imroshankr/Metal_detector/Metal_detector/report.txt

Info: Processing symbol 'C1:Capacitor_THT:C_Radial_D5.0mm_H11.0mm_P2.00mm'.
Info: Processing symbol 'R22:Resistor_THT:R_Axial_DIN0204_L3.6mm_D1.6mm_P7.62mm_Horizontal'.
Info: Processing symbol 'R23:Resistor_THT:R_Axial_DIN0204_L3.6mm_D1.6mm_P7.62mm_Horizontal'.
Info: Processing symbol 'R24:Resistor_THT:R_Axial_DIN0204_L3.6mm_D1.6mm_P7.62mm_Horizontal'.
Info: Processing symbol 'R25:Resistor_THT:R_Axial_DIN0204_L3.6mm_D1.6mm_P7.62mm_Horizontal'.
Info: Processing symbol 'C2:Capacitor_THT:C_Disc_D5.0mm_W2.5mm_P2.50mm'.
Info: Processing symbol 'C3:Capacitor_THT:C_Disc_D5.0mm_W2.5mm_P2.50mm'.
Info: Processing symbol 'C4:Capacitor_THT:C_Radial_D5.0mm_H11.0mm_P2.00mm'.
Info: Processing symbol 'C5:Capacitor_THT:C_Radial_D5.0mm_H11.0mm_P2.00mm'.
Info: Processing symbol 'C6:Capacitor_THT:C_Disc_D3.8mm_W2.6mm_P2.50mm'.
Info: Processing symbol 'C7:Capacitor_THT:C_Disc_D3.8mm_W2.6mm_P2.50mm'.
Info: Processing symbol 'C8:Capacitor_THT:C_Radial_D5.0mm_H11.0mm_P2.00mm'.
Info: Processing symbol 'R26:Resistor_THT:R_Axial_DIN0204_L3.6mm_D1.6mm_P7.62mm_Horizontal'.
Info: Processing symbol 'R27:Resistor_THT:R_Axial_DIN0204_L3.6mm_D1.6mm_P7.62mm_Horizontal'.
Info: Processing symbol 'C9:Capacitor_THT:C_Disc_D5.0mm_W2.5mm_P2.50mm'.
Info: Processing symbol 'R28:Resistor_THT:R_Axial_DIN0204_L3.6mm_D1.6mm_P7.62mm_Horizontal'.
Info: Processing symbol 'C10:Capacitor_THT:C_Disc_D5.0mm_W2.5mm_P2.50mm'.
Info: Processing symbol 'R29:Resistor_THT:R_Axial_DIN0204_L3.6mm_D1.6mm_P7.62mm_Horizontal'.
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
Error: Cannot add J4 (no footprint assigned).
Error: Cannot add J3 (no footprint assigned).
Error: Cannot add J7 (no footprint assigned).
Error: Cannot add U60 (footprint 'SN7404N:DIP794W45P254L1969H508Q14' not found).

Info: Total warnings: 18, errors: 5.
