imroshankr/Metal_detector/Metal_detector/Metal_detector.kicad_pcb

## KiCad design Metal_detector/Metal_detector.kicad_pcb (2024-08-18)

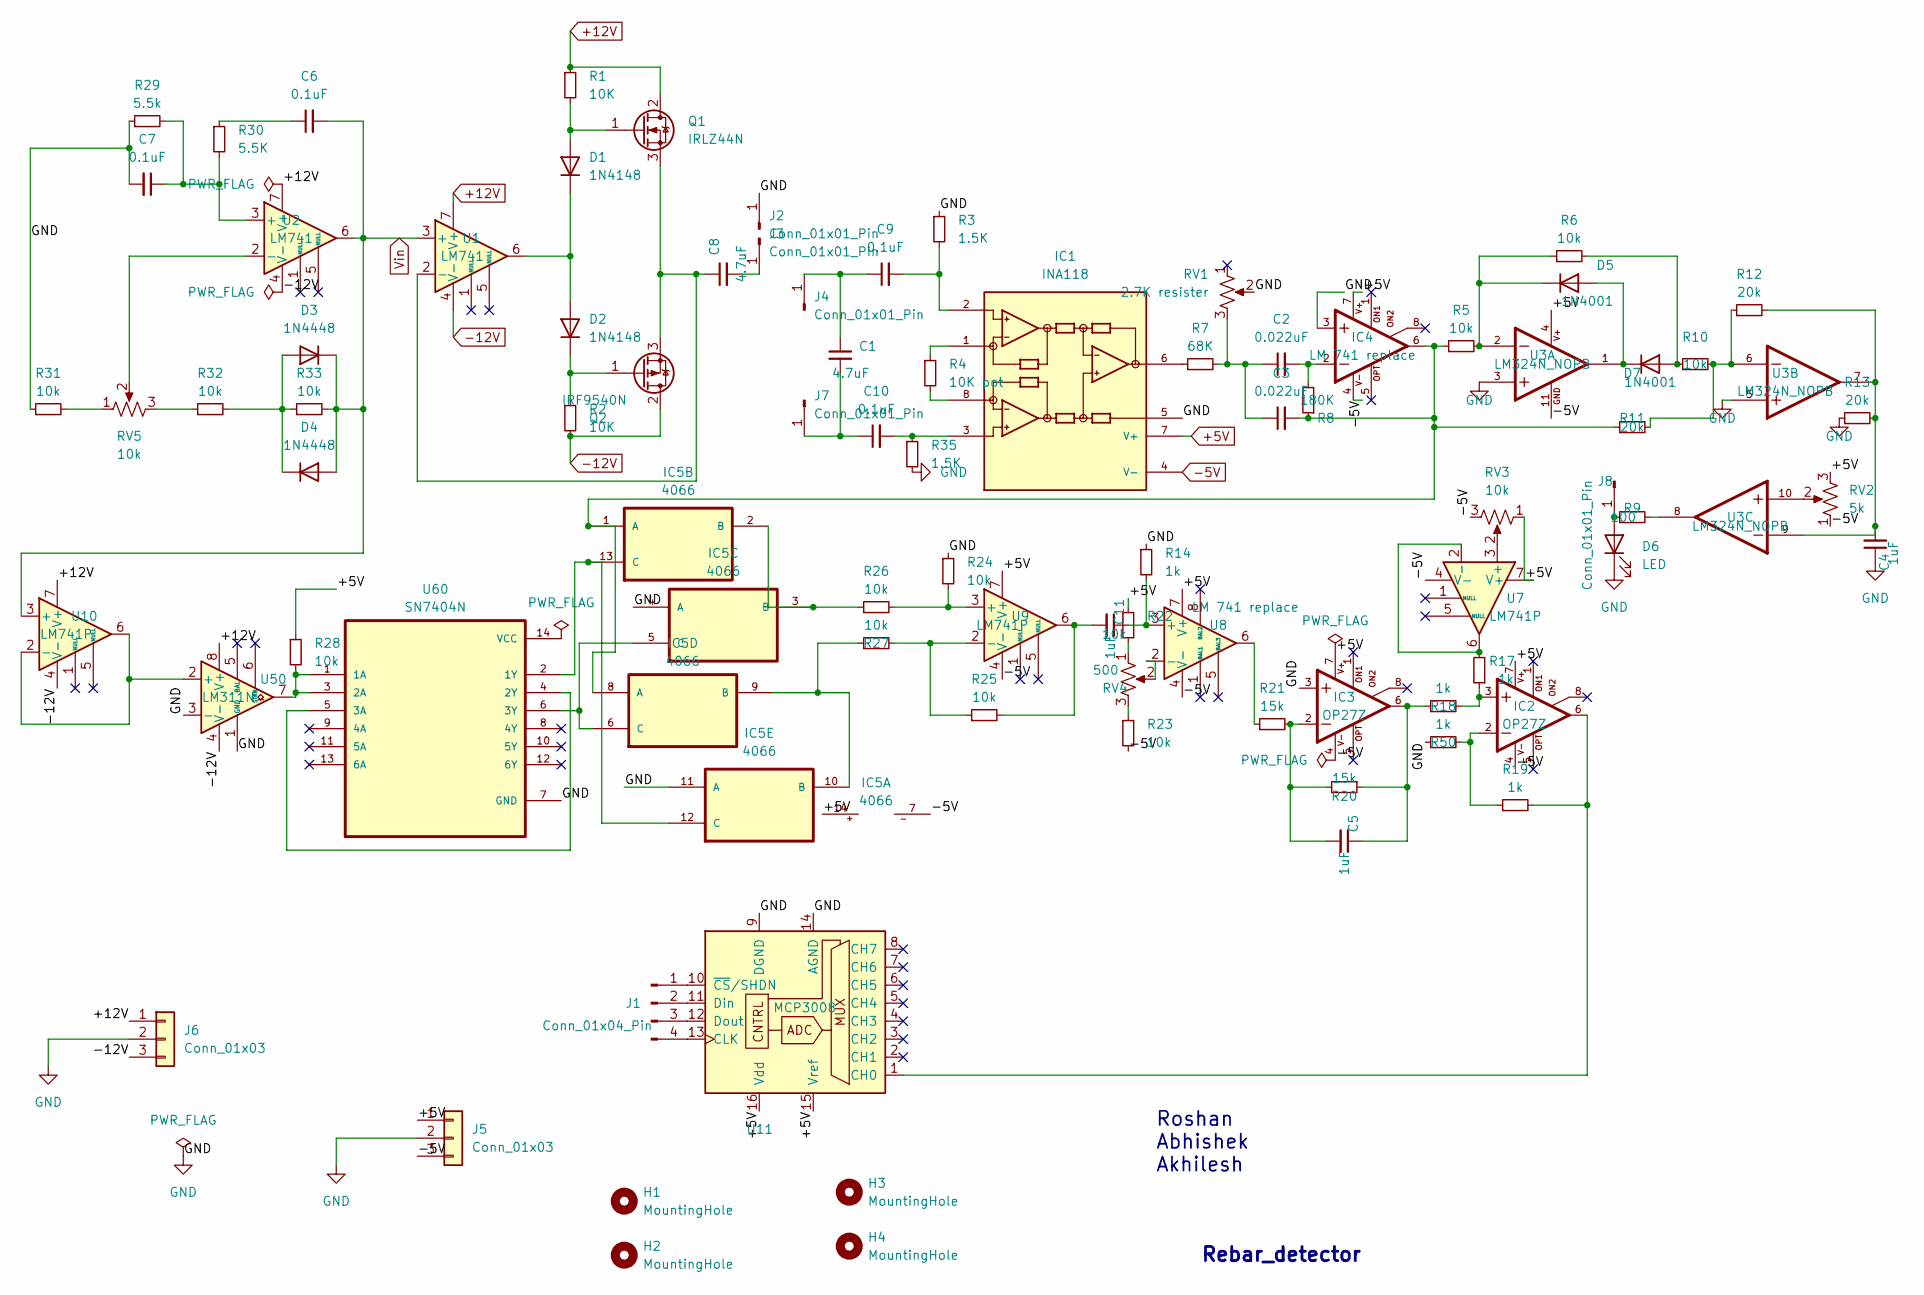
[picture p3: schematic Metal_detector.kicad_sch]

Parts:
C1, C8: 4.7uF; C_Radial_D6.3mm_H5.0mm_P2.50mm
C2, C3: 0.022uF; C_Disc_D5.0mm_W2.5mm_P2.50mm
C4: 1uF; C_Disc_D5.0mm_W2.5mm_P2.50mm
C5, C11: 1uF; C_Radial_D6.3mm_H5.0mm_P2.50mm
C6, C7: 0.1uF; C_Disc_D3.8mm_W2.6mm_P2.50mm
C9, C10: 0.1uF; C_Disc_D5.0mm_W2.5mm_P2.50mm
D1, D2: 1N4148; D_DO-35_SOD27_P7.62mm_Horizontal
D3, D4: 1N4448; D_DO-35_SOD27_P7.62mm_Horizontal
D5, D7: 1N4001; D_DO-41_SOD81_P10.16mm_Horizontal
D6: LED; LED_D3.0mm
H1, H2, H3, H4: MountingHole; MountingHole_3mm
IC1: INA118; DIP-8_W7.62mm_LongPads; MPN INA118U
IC2, IC3: OP27Z; DIP-8_W7.62mm_LongPads
IC4: LM 741 replace; DIP-8_W7.62mm_LongPads
IC5: 4066; DIP-14_W7.62mm_Socket_LongPads
J1: Conn_01x04_Pin; PinHeader_1x04_P2.54mm_Vertical
J2, J3, J4, J7, J8: Conn_01x01_Pin; Pin_D1.1mm_L10.2mm_W3.5mm_Flat
J5, J6: Conn_01x03; PinHeader_1x03_P2.54mm_Vertical
Q1: IRLZ44N; TO-220-3_Vertical
Q2: IRF9540N; TO-220-3_Vertical
R1, R2: 10K; R_Axial_DIN0204_L3.6mm_D1.6mm_P7.62mm_Horizontal
R3, R35: 1.5K; R_Axial_DIN0204_L3.6mm_D1.6mm_P7.62mm_Horizontal
R4: 10K pot; R_Axial_DIN0204_L3.6mm_D1.6mm_P7.62mm_Horizontal
R5, R6, R10, R22, R23, R24, R25, R26, R27, R28, R31, R32, R33: 10k; R_Axial_DIN0204_L3.6mm_D1.6mm_P7.62mm_Horizontal
R7: 68K; R_Axial_DIN0204_L3.6mm_D1.6mm_P7.62mm_Horizontal
R8: 180K; R_Axial_DIN0204_L3.6mm_D1.6mm_P7.62mm_Horizontal
R9: 100; R_Axial_DIN0204_L3.6mm_D1.6mm_P7.62mm_Horizontal
R11, R12, R13: 20k; R_Axial_DIN0204_L3.6mm_D1.6mm_P7.62mm_Horizontal
R14, R17, R18, R19, R50: 1k; R_Axial_DIN0204_L3.6mm_D1.6mm_P7.62mm_Horizontal
R20, R21: 15k; R_Axial_DIN0204_L3.6mm_D1.6mm_P7.62mm_Horizontal
R29: 5.5k; R_Axial_DIN0204_L3.6mm_D1.6mm_P7.62mm_Horizontal
R30: 5.5K; R_Axial_DIN0204_L3.6mm_D1.6mm_P7.62mm_Horizontal
RV1: 2.7K resister; Potentiometer_ACP_CA14-H5_Horizontal
RV2: 5k; Potentiometer_Bourns_3386F_Vertical
RV3, RV5: 10k; Potentiometer_ACP_CA14-H5_Horizontal
RV4: 500; Potentiometer_ACP_CA14-H5_Horizontal
U1, U2: LM741; DIP-8_W7.62mm
U3: LM324N_NOPB; DIP825W47P254L1917H533Q14; PARTREV D
U7, U9, U10: LM741P; DIP-8_W7.62mm
U8: LM 741 replace; DIP-8_W7.62mm
U11: MCP3008; DIP-16_W7.62mm
U50: LM311N; DIP-8_W7.62mm
U60: SN7404N; DIP794W45P254L1969H508Q14

Connections:
+5V: IC1.7 (V+), IC2.7, IC3.7, IC4.7, IC5.14, J5.1, R22.1, R28.1, RV2.3, RV3.1, U3.4, U7.7 (V+), U8.7 (V+), U9.7 (V+), U11.15 (Vref), U11.16 (Vdd)
+12V: J6.1, Q1.2 (D), R1.1, U1.7 (V+), U2.7 (V+), U10.7 (V+), U50.8 (V+)
-5V: IC1.4 (V-), IC2.4, IC3.4, IC4.4, IC5.7, J5.3, R23.2, RV2.1, RV3.3, U3.11, U7.4 (V-), U8.4 (V-), U9.4 (V-)
-12V: J6.3, Q2.2 (D), R2.2, U1.4 (V-), U2.4 (V-), U10.4 (V-), U50.4 (V-)
GND: C4.1, C7.2, D6.1 (K), IC1.5, IC3.3, IC4.3, IC5.4 (A), IC5.11 (A), J2.1, J5.2, J6.2, R3.1, R13.1, R14.1, R24.1, R29.1, R31.1, R35.2, R50.1, RV1.2, U3.3, U3.5, U11.9 (DGND), U11.14 (AGND), U50.1 (GND), U50.3 (-), U60.7 (GND)
unnamed: C2.1, C3.1, R7.2, RV1.3
unnamed: C2.2, IC4.2, R8.2
unnamed: C4.2, R12.2, R13.2, U3.7, U3.9
unnamed: C5.1, IC3.6, R18.1, R20.1
unnamed: C5.2, IC3.2, R20.2, R21.2
unnamed: C6.1, R30.1
unnamed: C9.2, IC1.2, R3.2
unnamed: C10.2, IC1.3, R35.1
unnamed: C11.2, R25.2, U9.6
unnamed: D1.2 (A), Q1.1 (G), R1.2
unnamed: D1.1 (K), D2.2 (A), U1.6
unnamed: D2.1 (K), Q2.1 (G), R2.1
unnamed: D3.2 (A), D4.1 (K), R32.2, R33.1
unnamed: D5.2 (A), D7.1 (K), U3.1
unnamed: D5.1 (K), R5.2, R6.1, U3.2
unnamed: D6.2 (A), J8.1, R9.1
unnamed: D7.2 (A), R6.2, R10.1
unnamed: IC1.1, R4.1
unnamed: IC1.6, R7.1
unnamed: IC1.8, R4.2
unnamed: IC2.2, R19.1, R50.2
unnamed: IC2.3, R17.1, R18.2
unnamed: C3.2, IC4.6, IC5.1 (A), IC5.8 (A), R5.1, R8.1, R11.1
unnamed: IC5.2 (B), IC5.3 (B), R26.1
unnamed: IC5.12 (C), IC5.13 (C), U60.2 (1Y)
unnamed: IC5.5 (C), IC5.6 (C), U60.6 (3Y)
unnamed: IC5.9 (B), IC5.10 (B), R27.1
unnamed: J1.1, U11.10 (~CS/SHDN)
unnamed: J1.2, U11.11 (Din)
unnamed: J1.3, U11.12 (Dout)
unnamed: J1.4, U11.13 (CLK)
unnamed: C8.2, J3.1
unnamed: C1.1, C9.1, J4.1
unnamed: C1.2, C10.1, J7.1
unnamed: C8.1, Q1.3 (S), Q2.3 (S), U1.2 (-)
unnamed: R9.2, U3.8
unnamed: R10.2, R11.2, R12.1, U3.6
unnamed: R21.1, U8.6
unnamed: R22.2, RV4.1
unnamed: R23.1, RV4.3
unnamed: R31.2, RV5.1
unnamed: R32.1, RV5.3
unnamed: RV2.2, U3.10
unnamed: C7.1, R29.2, R30.2, U2.3 (+)
unnamed: RV5.2, U2.2 (-)
unnamed: RV3.2, U7.3 (+)
unnamed: R17.2, U7.2 (-), U7.6
unnamed: C11.1, R14.2, U8.3 (+)
unnamed: RV4.2, U8.2 (-)
unnamed: R24.2, R26.2, U9.3 (+)
unnamed: R25.1, R27.2, U9.2 (-)
unnamed: U10.2 (-), U10.6, U50.2 (+)
unnamed: IC2.6, R19.2, U11.1 (CH0)
unnamed: R28.2, U50.7, U60.1 (1A), U60.3 (2A)
unnamed: U60.4 (2Y), U60.5 (3A)
Vin: C6.2, D3.1 (K), D4.2 (A), R33.2, U1.3 (+), U2.6, U10.3 (+)

Notes on the sheet:
Rebar_detector
Roshan Abhishek Akhilesh

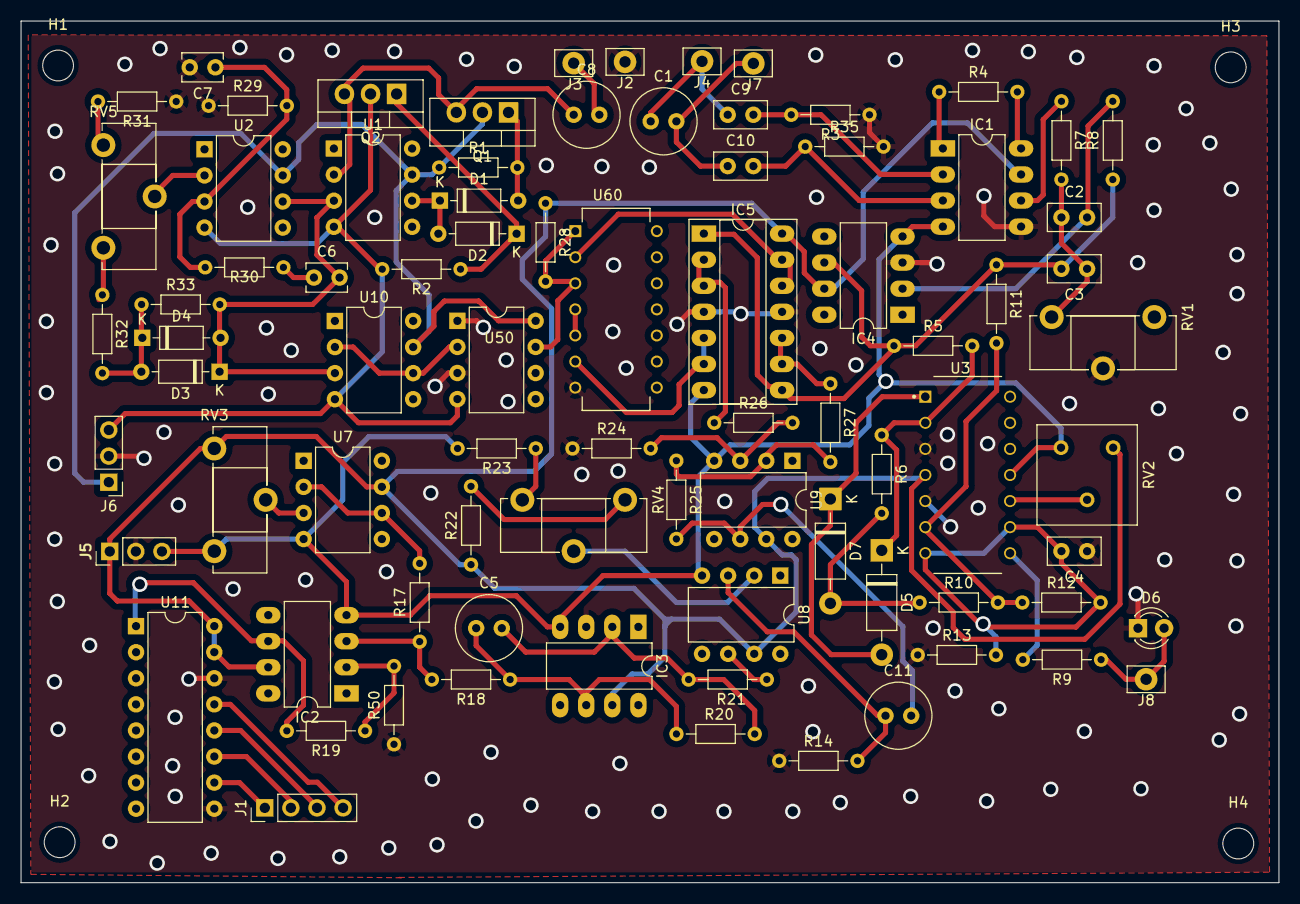
[picture p4: board Metal_detector.kicad_pcb from above]

Board: 2 copper layers, 122.5 x 83.9 mm, 85 parts (0 on the bottom side), 61 nets.
