imroshankr/Metal_detector/Metal_detector/rebar_detector/rebar_detector.kicad_pcb

## KiCad design Metal_detector/rebar_detector/rebar_detector.kicad_pcb (2024-08-18)

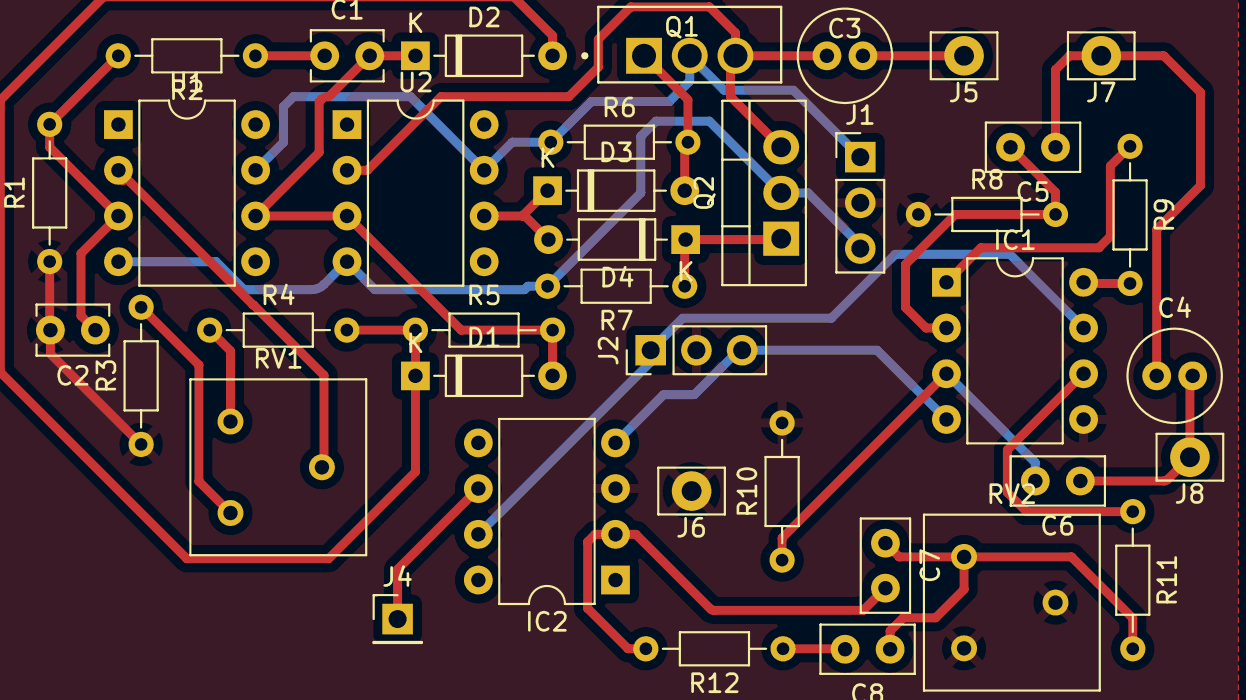
[picture p5: board rebar_detector.kicad_pcb from above]

Board: 2 copper layers, 39 parts (0 on the bottom side), 28 nets.

Parts:
C1, C2: 22pF; C_Disc_D3.8mm_W2.6mm_P2.50mm
C3, C4: 4.7uF; C_Radial_D5.0mm_H11.0mm_P2.00mm
C5, C6, C7, C8: 0.1uF; C_Disc_D5.0mm_W2.5mm_P2.50mm
D1, D2: 1N4448; D_DO-35_SOD27_P7.62mm_Horizontal
D3, D4: 1N4148; D_DO-35_SOD27_P7.62mm_Horizontal
IC1: INA118; DIP-8_W7.62mm
IC2: OP27Z; DIP-8_W7.62mm
J1, J2: Conn_01x03; PinHeader_1x03_P2.54mm_Vertical
J4: Conn_01x01; PinHeader_1x01_P2.54mm_Vertical
J5, J6, J7, J8: Conn_01x01_Pin; Pin_D1.1mm_L10.2mm_W3.5mm_Flat
Q1: IRFZ44N; TO254P1016X419X2286-3
Q2: IRF9540N; TO-220-3_Vertical
R1: 1.3k; R_Axial_DIN0204_L3.6mm_D1.6mm_P7.62mm_Horizontal
R2: 1.3K; R_Axial_DIN0204_L3.6mm_D1.6mm_P7.62mm_Horizontal
R3, R4, R5: 10k; R_Axial_DIN0204_L3.6mm_D1.6mm_P7.62mm_Horizontal
R6, R7: 10K; R_Axial_DIN0204_L3.6mm_D1.6mm_P7.62mm_Horizontal
R8, R10: 1.7K; R_Axial_DIN0204_L3.6mm_D1.6mm_P7.62mm_Horizontal
R9: 470; R_Axial_DIN0204_L3.6mm_D1.6mm_P7.62mm_Horizontal
R11: 7.6k; R_Axial_DIN0204_L3.6mm_D1.6mm_P7.62mm_Horizontal
R12: 30.47k; R_Axial_DIN0204_L3.6mm_D1.6mm_P7.62mm_Horizontal
RV1: 10k; Potentiometer_Bourns_3386F_Vertical
RV2: 100; Potentiometer_Bourns_3386F_Vertical
U1, U2: LM741; DIP-8_W7.62mm

Connections:
+12V: J1.1, Q1.2, R6.1, U1.7 (V+), U2.7 (V+)
-12V: J1.3, Q2.2 (D), R7.2, U1.4 (V-), U2.4 (V-)
/+5V: IC1.7 (V+), IC2.7, J2.1
/-5V: IC1.4 (V-), IC2.4, J2.3
GND: C2.2, IC1.5, IC2.3, J1.2, J2.2, J6.1, R1.1, R3.1, R8.1, R10.2, RV2.1, RV2.2
unnamed: C1.1, R2.1
unnamed: C5.2, IC1.2, R8.2
unnamed: C6.2, IC1.3, R10.1
unnamed: C7.1, C8.1, R11.2, RV2.3
unnamed: C7.2, IC2.2, R12.2
unnamed: C8.2, R12.1
unnamed: C1.2, D1.2 (A), D2.1 (K), R5.2, U1.6, U2.3 (+)
unnamed: D1.1 (K), D2.2 (A), R4.2, R5.1
unnamed: D3.2 (A), Q1.1, R6.2
unnamed: D3.1 (K), D4.2 (A), U2.6
unnamed: D4.1 (K), Q2.1 (G), R7.1
unnamed: IC1.1, R9.1
unnamed: IC1.6, R11.1
unnamed: IC1.8, R9.2
unnamed: IC2.6, J4.1
unnamed: C3.2, J5.1
unnamed: C4.1, C5.1, J7.1
unnamed: C4.2, C6.1, J8.1
unnamed: C3.1, Q1.3, Q2.3 (S), U2.2 (-)
unnamed: R3.2, RV1.1
unnamed: R4.1, RV1.3
unnamed: C2.1, R1.2, R2.2, U1.3 (+)
unnamed: RV1.2, U1.2 (-)
